Invary/cnc/README.md

# How to setup/use CNC3040 with GRBL

## About　

Smaller CNCs such as the CNC3018 use GRBL as the controller. <br />
However, for CNC3040 and above, Mache 3/4, which is older in design and less user-friendly, is often used. Here we show how to build a CNC3040 system with GRBL/wifi. <br />

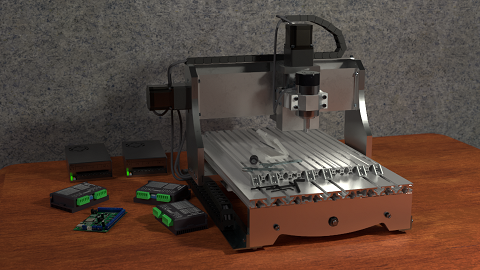
[picture p1: img/all_480x270.png]
CNC3040


<br />

## Preparation / CNC3040Z

Required <br/>
* CNC DIY frame. 3Axis [CNC3040Z](https://s.click.aliexpress.com/e/_DC8N8X1) without motor <br />
* 2 motor. Dual 8mm shaft NEMA23 motor, [23HS5628-SZ](https://s.click.aliexpress.com/e/_Dlx0W5N) for X/Z axis <br />
* 1 motor. Mono 8mm shaft NEMA23 motor, [23HS5628-8mm](https://s.click.aliexpress.com/e/_DmWwv0B) for Y axis <br />
* 3 coupling, [8mm x 8mm](https://s.click.aliexpress.com/e/_DkbfAH5) <br />
* 3 driver. [DM542](https://s.click.aliexpress.com/e/_DnLqMan) <br />
* Spindle. [BLDC 300W spindle](https://s.click.aliexpress.com/e/_DeVVoub) with driver, holder, speed meter and ER11 <br />
* GRBL board. [32bit 6axis CNC card](https://s.click.aliexpress.com/e/_DBUy0Rt) <br />
* Power unit. [24V 360W-Quiet](https://s.click.aliexpress.com/e/_DdIBWQr) for motors <br />
* Power unit. [36V 400W-Quiet](https://s.click.aliexpress.com/e/_DdIBWQr) for spindle <br />
* Shielded cable. [4core 18AWG 10m](https://s.click.aliexpress.com/e/_DBOf5Yn) for motors <br />
* Shielded cable. [3core 18AWG 5m](https://s.click.aliexpress.com/e/_DBOf5Yn) for spindle <br />
* microSD card. 1GB <br />

Optional <br />
* Ribon cable. [28AWG 5m](https://s.click.aliexpress.com/e/_DCX7pV1) <br />
* XH2.54 connector. [230Pcs XH2.54](https://s.click.aliexpress.com/e/_Dmz7UOf) for motors <br />
* Ferrule connector. [Many types of 340pcs](https://s.click.aliexpress.com/e/_DCKdpaT) for GRBL board and drivers <br />
* Terminal connector. [OT-3A](https://s.click.aliexpress.com/e/_DBOf5Yn) for power units <br />
* Drag chain. [inner size 10x20mm 2m](https://s.click.aliexpress.com/e/_DDre0dV) <br />
* Cable tie. [3x100mm](https://s.click.aliexpress.com/e/_DB07H2F) <br />
* 3D printer <br />

** Shielded cable is required. Unshielded cables will cause motor errors such as stalling. <br />

<br />

## Test wifi connection

GRBL board, [32bit 6axis CNC card](https://s.click.aliexpress.com/e/_DBUy0Rt), is equipped with an EPS32 and has a standard [FluidNC](https://github.com/bdring/FluidNC)(GRBL for ESP32) firmware burned in. <br />
Wireless connectivity is supported. Before wiring, first check this operation. <br />
This board is compatible with 12-24V power supply, 36V is not support. <br />

Connect to 24V power supply. Then the on-board LED glows momentarily and ESP32 operates as an access point mode. <br />
Enable the wireless on your smartphone or PC and you can find the SSID **`GRBL_ESP`**. The password is **`12345678`**. <br />

Once connected to the GRBL board, access **`http://192.168.100.101/`** in your browser. <br />
If connection failed, try another URL **`http://192.168.100.104/`** , **`http://192.168.101.100/`** or so on. Or, open a command prompt on your PC and run **`arp -a`** to identify the IP address = URL. <br />

<br />

## Motors wiring

GRBL board, [32bit 6axis CNC card](https://s.click.aliexpress.com/e/_DBUy0Rt), is equipped with an EPS32 and has a standard [FluidNC](https://github.com/bdring/FluidNC)(GRBL for ESP32) firmware burned in. <br />

* PUL/DIR/EN pins are 5V high/low output. DO NOT connect to over 5V voltage power supply. <br />
* High voltage of PWM-OUT is adjustable. <br />
* Both 24V pins are directly connected. Therefore, they can be used for both IN and OUT. <br />

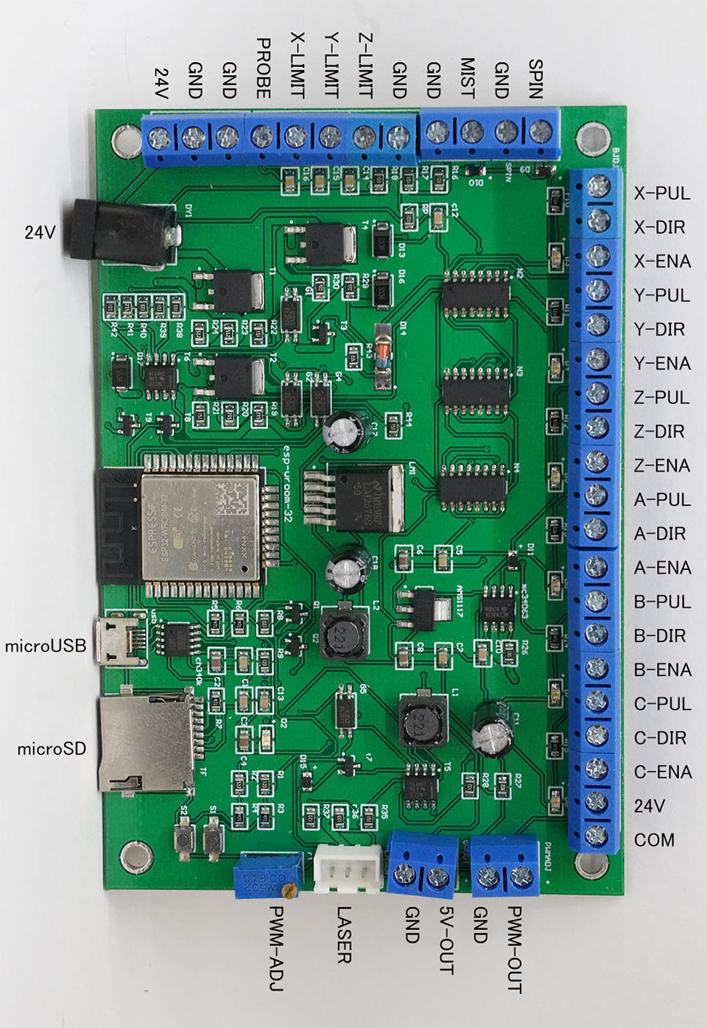
[picture p2: img/grbl_board_960x1396.png]
GRBL board


<br />

[DM542](https://s.click.aliexpress.com/e/_DnLqMan) is stepper motor driver. <br />
This is compatible with 20-50V power supply. <br />

* PUL-/DIR-/ENA- pins are connected to GND. <br />
* If you want to keep motor always on, connect both ENA+/ENA- pins to GND. <br />
* When wiring more than 2m, use shileded cable, or motor trouble will occur. <br />

<br />

Dual 8mm shaft NEMA23 motor, [23HS5628-SZ](https://s.click.aliexpress.com/e/_Dlx0W5N) for X/Z axis <br />
Mono 8mm shaft NEMA23 motor, [23HS5628-8mm](https://s.click.aliexpress.com/e/_DmWwv0B) for Y axis <br />
23HS5628 is 56mm height, 2.8A, 126N.cm. <br />

* Pin assignments vary by product, so check with a tester. <br />

<br />

The direction of motor rotation is not important because it can be changed by software.

DIP switch setting of DM542 is **`1.0A`**, **`Full Current`**, **`25600`** steps, **`on on on on off off off on`**. <br />
The motor's rated current is 2.8 A, but it is better to keep the value small unless it is necessary because it generates more heat. <br />

CNC3040Z's ball screw are SFU1605 with 5mm pitch. <br />
In other words, the 25600 steps in DM542 are 5mm, so **`5120 steps/mm`**. <br />

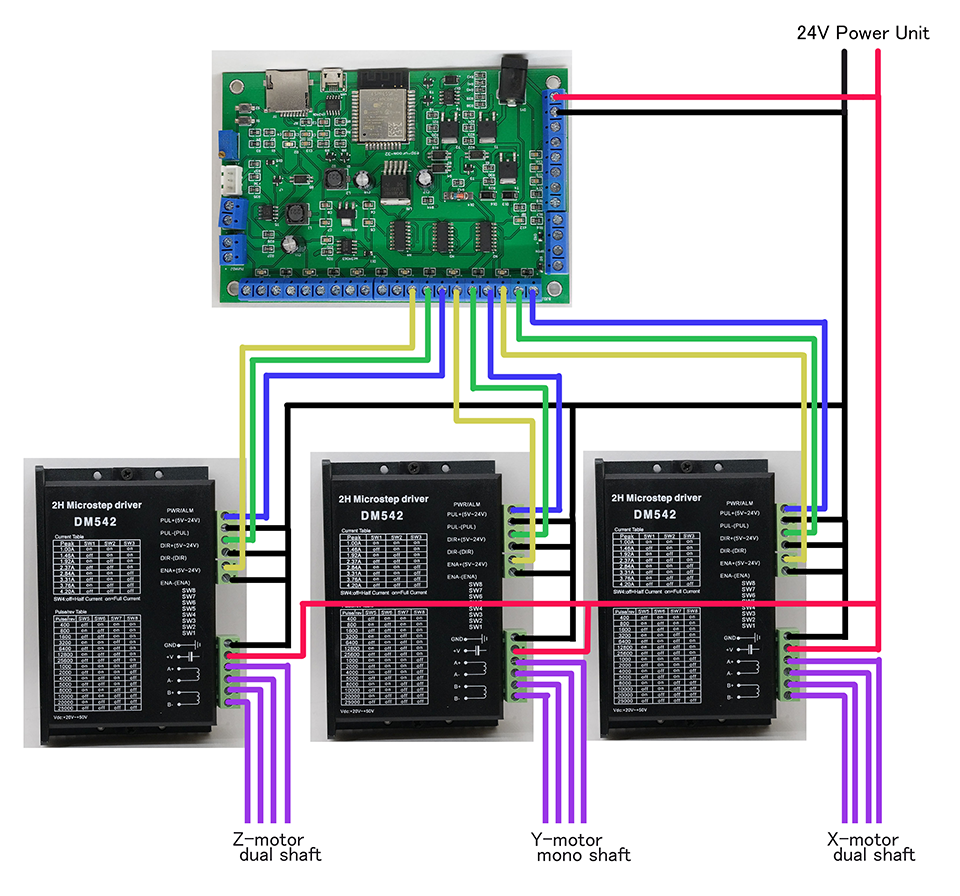
[picture p3: img/connection_motor_960x896.png]
Connections for motors


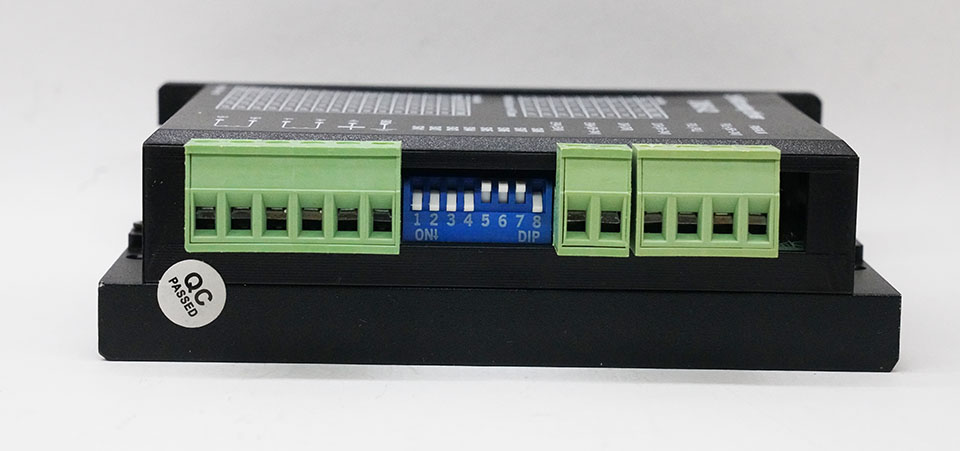
[picture p4: img/dm542_side_960x451.jpg]
Setting of DM542


<br />

## Spindle wiring

[WS55-180](https://s.click.aliexpress.com/e/_DeVVoub) is brushless spindle motor driver. <br />
RPM can be manually set by volume (10k ohm) or automatically adjusted by G-CODE. <br />

For automatic control, turn the **`PWM-ADJ`** volume to 0-10V PWM output before wiring. <br />
To adjust, access GRBL board with a browser. Set speed value **`1000`** in spindle tab and press the **`On Fwd`** button. Then voltage is output to PWM-OUT pin. Turn the **`PWM-ADJ`** volume so that the output is 10V. <br />

The direction of spindle rotation is important. Be sure to set correctly by change order U/V/W to U/W/V, etc., if in reverse. <br />
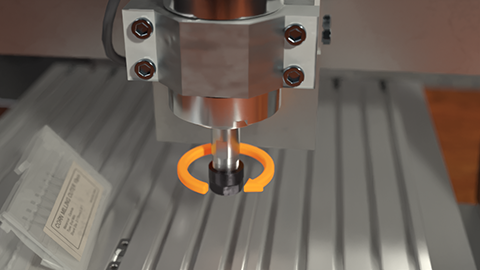
[picture p5: img/spindle_direction_480x270.png]
Auto control connections for spindle


- Manual control
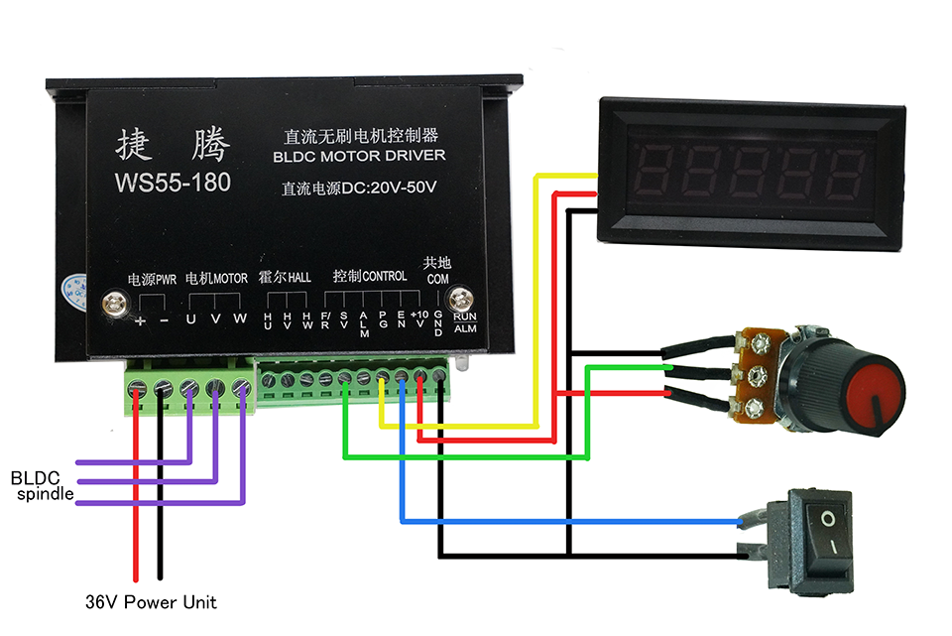
[picture p6: img/connection_spindle_manual_960x641.png]
Manual control connections for spindle


- Automatic control
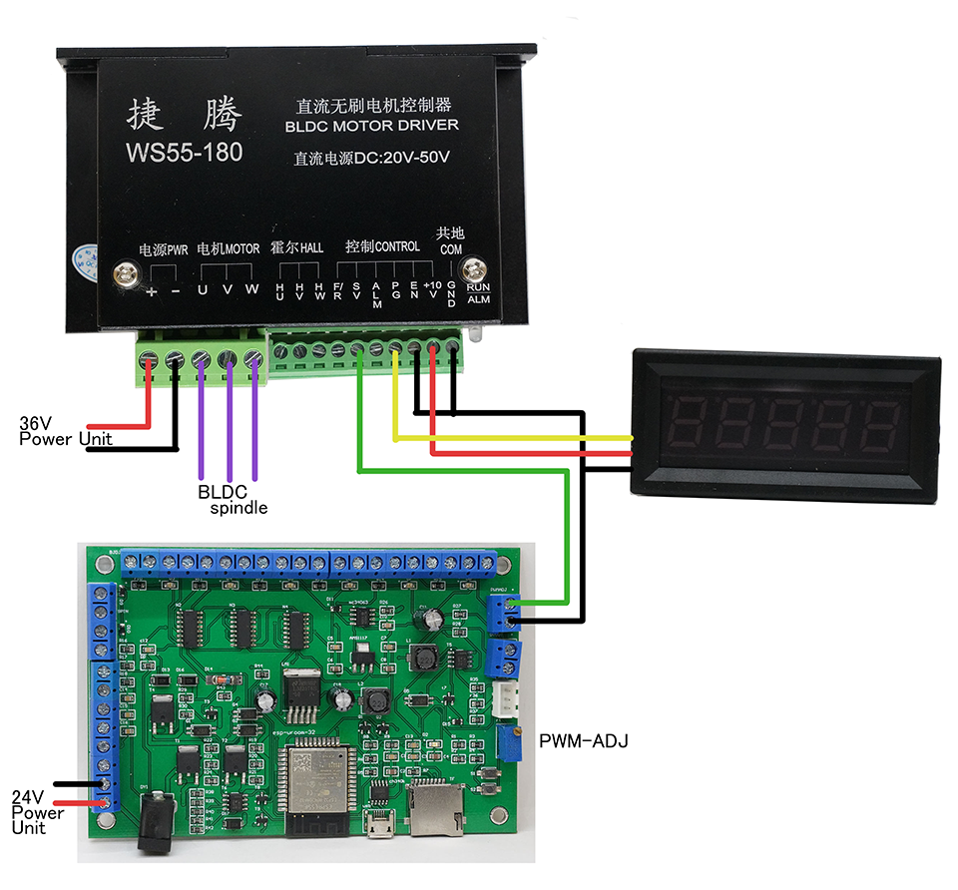
[picture p7: img/connection_spindle_auto_960x892.png]
Auto control connections for spindle


- Value in G-CODE vs RPM (no load)

| value |  rpm  |
| ----: | ----: |
| 200 |  2200 |
| 300 |  3800 |
| 400 |  5400 |
| 500 |  6800 |
| 600 |  8000 |
| 700 |  9200 |
| 800 | 10200 |
| 900 | 11300 |
|  1000 | 12000 |

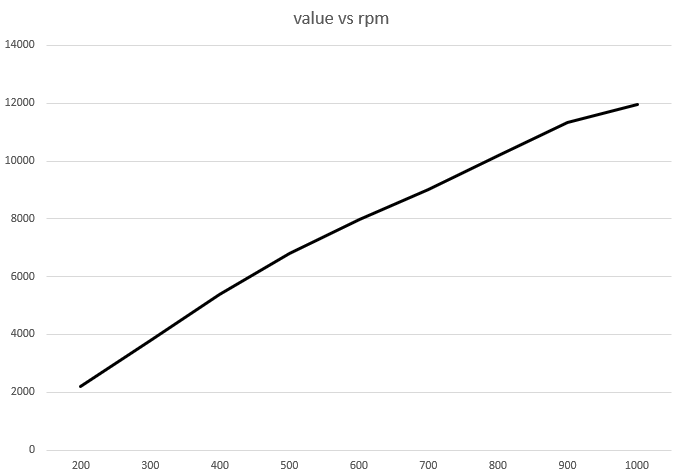
[picture p8: img/spindle_rpm_682x476.png]
g-code value vs rpm


<br />

## GRBL/[FluidNC](https://github.com/bdring/FluidNC) setting

To change the GRBL configuration, follow the steps below. <br />

1. Access GRBL board with browser <br />
2. Download the configuration file from GRBL board to your PC <br />
3. Edit the configuration file on your PC <br />
4. Upload the file to GRBL board <br />
5. Restart GRBL board <br />
<br />

Here is my [CNC3040Z configuration file](https://github.com/Invary/cnc/blob/main/cnc3040z.yaml) <br />

The various port settings on the GRBL board are not problm as default. <br />
The following items are important <br />

**`steps_per_mm:`** of X/Y/Z set to **`5120.000`**. <br />
**`max_rate_mm_per_min:`** of X/Y/Z set to **`500.000`**. <br />

**`homing:cycle:`** of X/Y set to **`1`**. <br />
**`homing:cycle:`** of Z/A/B/C set to **`0`**. <br />

**`max_travel_mm:`** of X set to **`300mm`**. <br />
**`max_travel_mm:`** of Y set to **`400mm`**. <br />
**`max_travel_mm:`** of Z set to **`100mm`**. <br />

**`start:must_home;`** set to **`false`**. <br />

When the direction of the stepping motor is reverse rotation, edit **`direction_pin:`**. <br />
Just add **`:low`** to reverse rotation, ex. **`direction_pin: I2SO.4`** to **`direction_pin: I2SO.4:low`** <br />

<br />

## Offline controller

GRBL board, [32bit 6axis CNC card](https://s.click.aliexpress.com/e/_DBUy0Rt), has no port for offline controller. <br />
But you can control via wifi. Although it is not an offline controller, it can be used like an offline controller. <br />

1. With smart phone, access GBRL board with browser. <br />
2. Open **`Tablet`** tab. <br />
3. You can control CNC via wifi. <br />

<br />

## Stand alone CNC machining

GRBL board, [32bit 6axis CNC card](https://s.click.aliexpress.com/e/_DBUy0Rt), has a microSD slot. <br />
Stand-alone processing is available by uploading g-code file in microSD. Upload can do via wifi. <br />

1. Access GBRL board with browser. <br />
2. Upload g-code file to microSD. File extension is like **`.nc`**. <br />
3. Set **`GRBL Reports:`** to **`Auto`** <br />
4. Set endmill to the spindle. <br />
5. Move spindle head to start position. <br />
6. Press **`⌀XYZABC`** button, work coordinates set to zero. <br />
7. Start CNC machining. <br />

If you want to abort, press pause and refresh button. <br />

<br />

## Serial connected CNC machining

GRBL board, [32bit 6axis CNC card](https://s.click.aliexpress.com/e/_DBUy0Rt), has a microUSB connector. <br />
It supports HID/serial protocol. So you can control CNC via serial port. <br />

<br />

## Serial connected CNC machining via wifi

GRBL board, [32bit 6axis CNC card](https://s.click.aliexpress.com/e/_DBUy0Rt) with firmware of [FluidNC](https://github.com/bdring/FluidNC), supports multiple wireless protocol. <br />
So you can control CNC via wifi, and by using a wireless-serial port bridge with virtual serial port, it can be controlled like as wired connected CNC. <br />

* Bluetooth/serial (not recommended) <br />
* WebSocket via wifi (not recommended) <br />
* Telnet via wifi (recommended) <br />

Bluetooth is for exclusive use with wifi. Therefore, enabling bluetooth is not recommended since wifi is not available. <br />

WebSocket is also used for control by browsers. This is not recommended as the connection is a bit unstable and can be dropped. <br />

So telnet/wifi is recommended. <br />

The following is an example of a setup is with [Candle](https://github.com/Denvi/Candle) for windows. <br />

1. Install virtual serial port [com0com](https://sourceforge.net/projects/com0com/files/com0com/3.0.0.0/). <br />
2. In setup of com0com, check **`enumulate baudrate`** and add one pair of virtual serial port, COM19 & COM20. <br />
3. [Download](https://github.com/Invary/IvyTcp2Serial/releases) latest version of [IvyTcp2Serial](https://github.com/Invary/IvyTcp2Serial/) and extract. <br />
4. Create shortcut file of **`IvyTcp2Serial.exe`** .<br />
5. Right click shortcut file and open property. <br />
6. Edit shortcut link **`IvyTcp2Serial.exe`** to **`IvyTcp2Serial.exe /server=192.168.100.101 /port=23 /comport=COM19 /baudrate=115200 /parity=none /stopbits=1`**. IP address and comport should be changed according to your environment. <br />
7. Execute IvyTcp2Serial with serial, and connected to CNC via wifi/telnet. <br />
8. Execute Candle with serial port like **`COM20`**. <br />
9. At first, send command to CNC, **`$Report/Interval=50`**. This is because the default frequency of coordinate report is low. <br />
10. Now you can control CNC via wifi with Candle. <br />

<br />

## Cable management

[CNC3040Z](https://s.click.aliexpress.com/e/_DC8N8X1) has several screw holes for cable management and comes with an adapter to secure the drag chain. <br />
However, we don't know which drag chain would fit perfectly. So, we made our own adapter with 3D printer. <br />

Usable drag chain is [inner size 10x20mm](https://s.click.aliexpress.com/e/_DDre0dV), close type. <br />
Since there are slight differences in size between drag chain products, it is better to design your own 3D printed parts without using stl. <br />

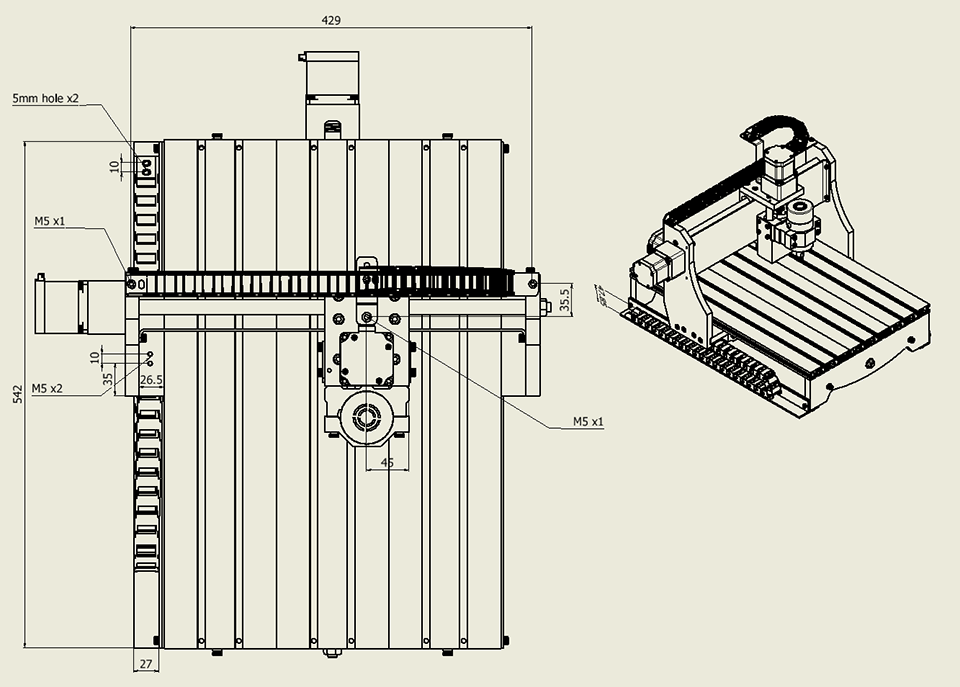
[picture p9: img/dimension_dragchain_hole_960x687.png]
Dimension for drag chain


The required length of the X axis drag chain is about 60cm. <br />

Stl file of [drag chain end cap for X axis type1](https://github.com/Invary/cnc/blob/main/model/3dprint/dragchain_end_x1.stl)
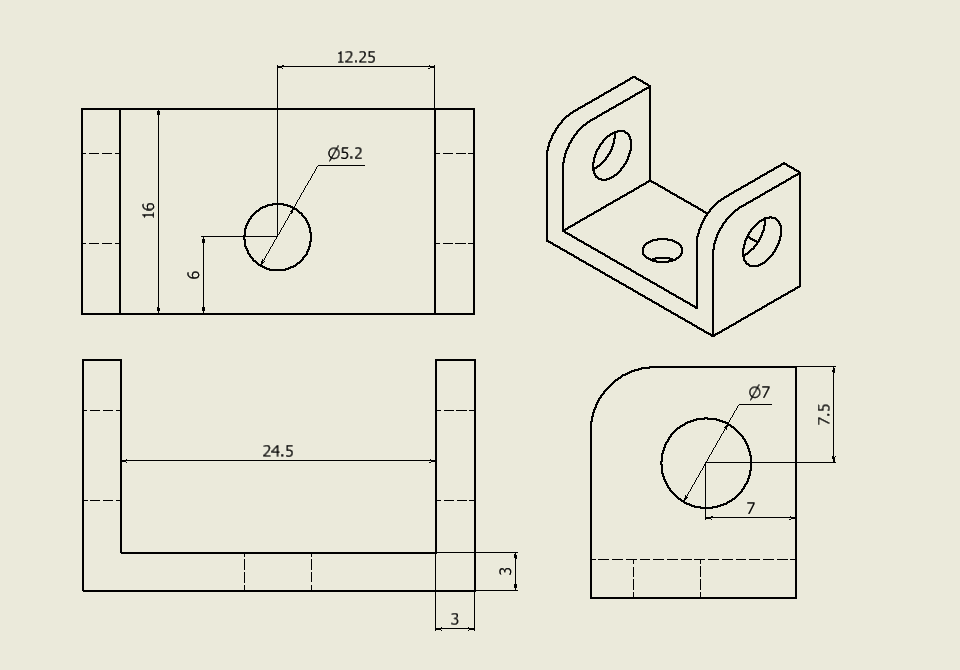
[picture p10: img/dragchain_end_x1_960x670.png]
drag chain end cap for X


Stl file of [drag chain end cap for X axis type2](https://github.com/Invary/cnc/blob/main/model/3dprint/dragchain_end_x2.stl) <br />
Multiple holes are for cable tie [3x100mm](https://s.click.aliexpress.com/e/_DB07H2F) <br />
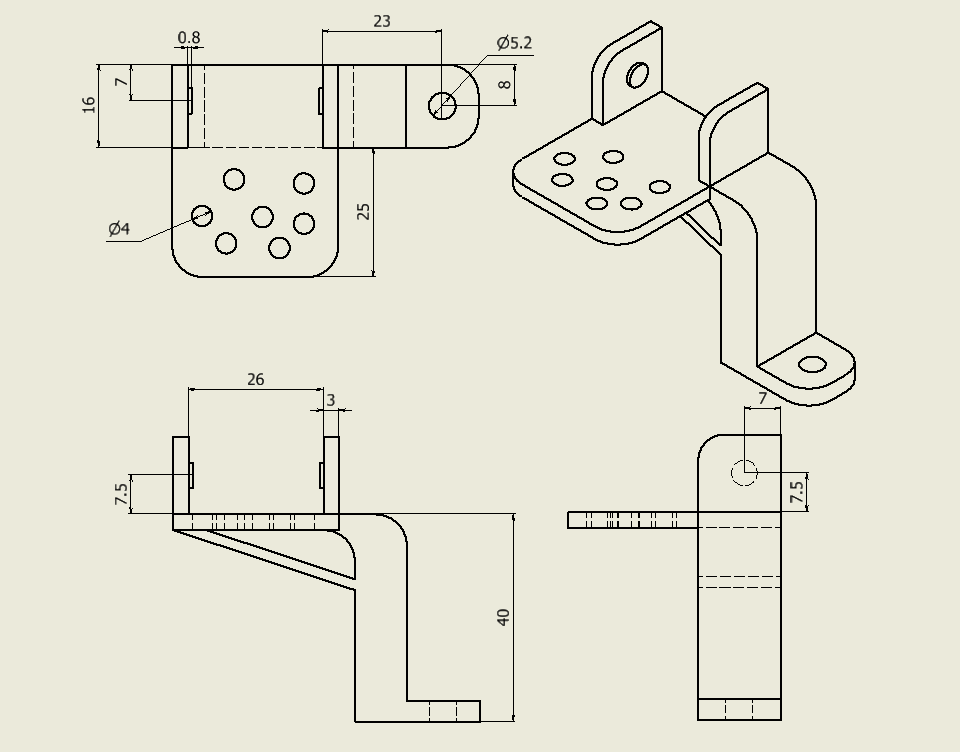
[picture p11: img/dragchain_end_x2_960x752.png]
drag chain end cap for X


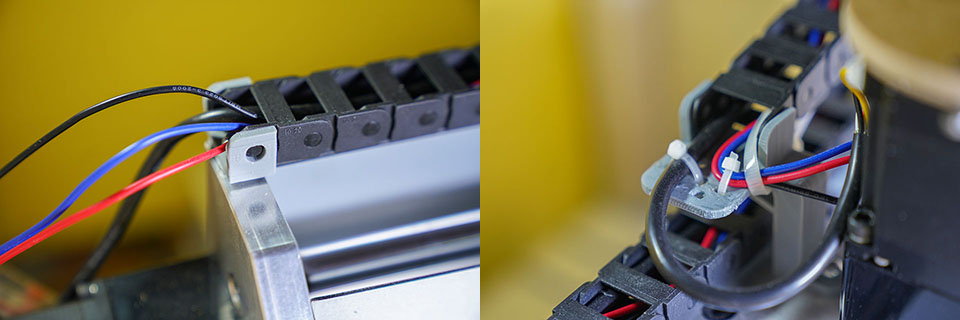
[picture p12: img/DSC06139_960x320.JPG]


The required length of the Y axis drag chain is about 70cm. <br />
The gap between the stage and the side panel is 26.5mm, which is a little narrow for a drag chain. Therefore, it is fixed in an irregular manner. <br />

Stl file of [drag chain end cap for Y axis](https://github.com/Invary/cnc/blob/main/model/3dprint/dragchain_end_y.stl)
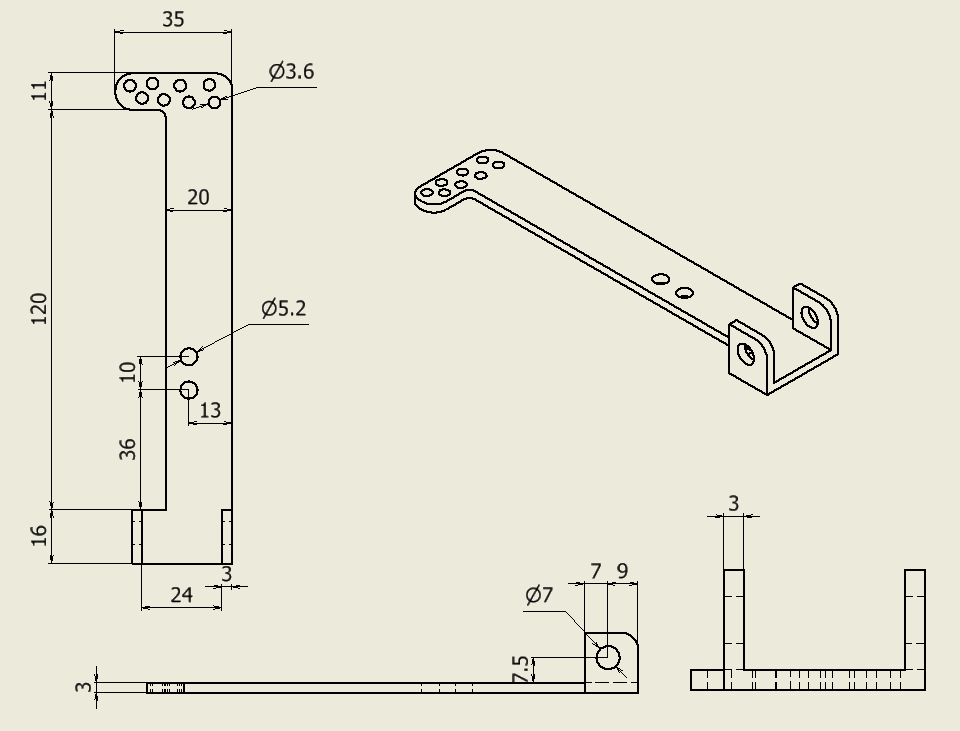
[picture p13: img/dragchain_end_y_960x731.png]
drag chain end cap for Y


M5 screw holes are provided near the Y-axis motor. This is used to secure the cable between Y-axis and X-axis. <br />
Stl file of [cable adapter between Y and X](https://github.com/Invary/cnc/blob/main/model/3dprint/cable_adapter.stl)
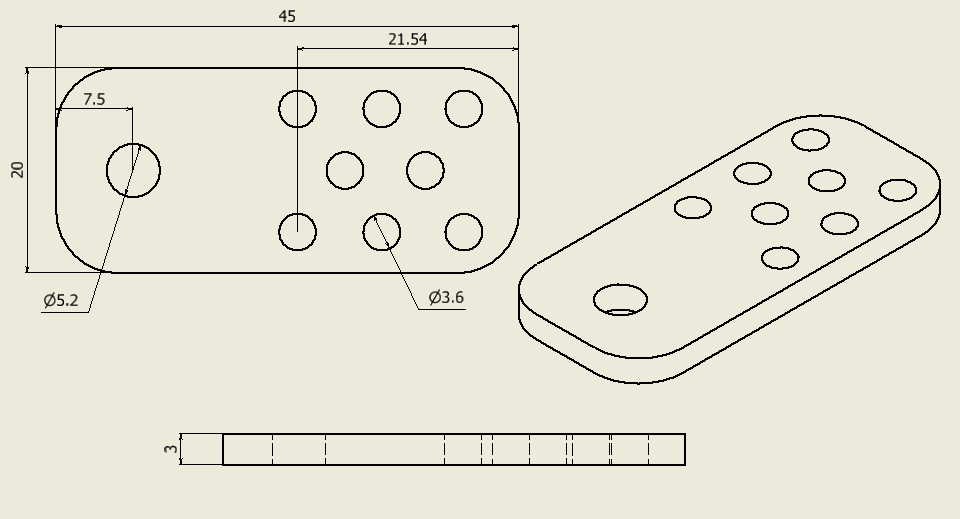
[picture p14: img/cable_adapter_960x519.png]
cable adapter between Y and X


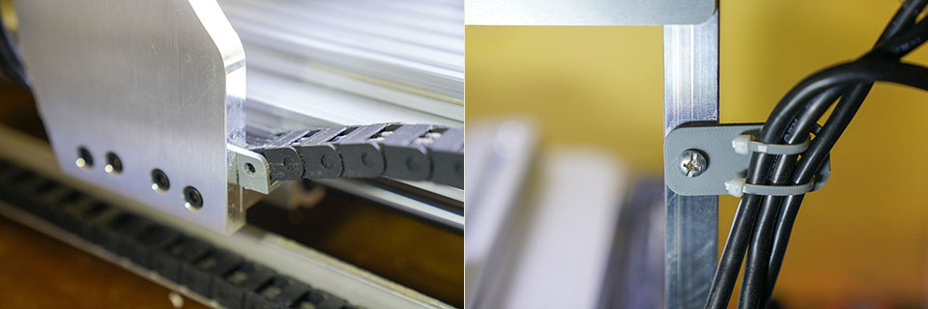
[picture p15: img/DSC06147_960x320.JPG]
drag chain end cap for Y, cable adapter between Y and X


<br />

## Power unit terminal guard

This CNC use 2 power units, [24V 360W-Quiet](https://s.click.aliexpress.com/e/_DdIBWQr) and [36V 400W-Quiet](https://s.click.aliexpress.com/e/_DdIBWQr). <br />
This power unit is easy to short-circuit because the terminals are exposed. Create a protective cover. <br />

Stl file of [Power unit terminal guard](https://github.com/Invary/cnc/blob/main/model/3dprint/power_unit_guard.stl)
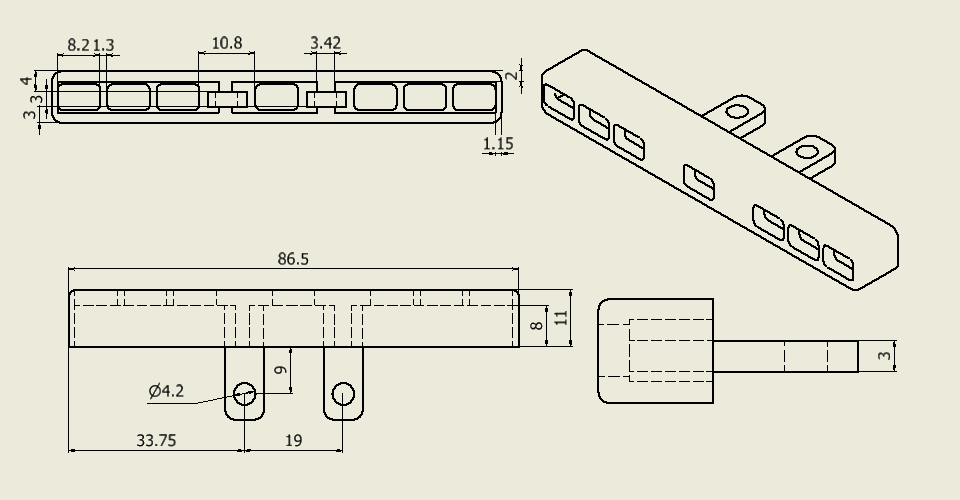
[picture p16: img/power_unit_guard_960x500.png]
Power unit guard


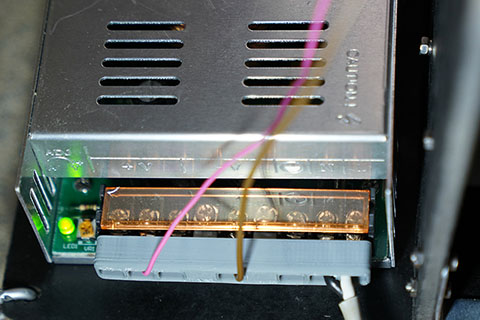
[picture p17: img/DSC06148_480x320.JPG]


<br />

## Knob for X/Z axis

Knob on dual shaft motor make manual position adjustment easier. <br />
So, for X/Z axis, It is better to use dual shaft motors, [23HS5628-SZ](https://s.click.aliexpress.com/e/_Dlx0W5N). <br />

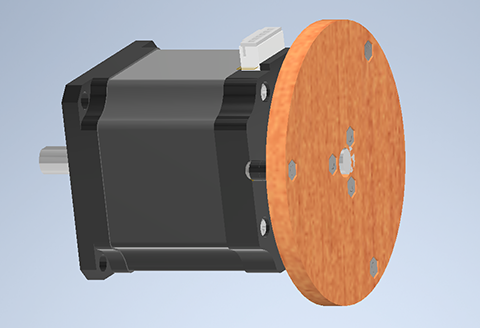
[picture p18: img/nema23_with_knob1_480x328.png]
NEMA23 with knob


Parts list
- x1 dual 8mm shaft NEMA23 motor, [23HS5628-SZ](https://s.click.aliexpress.com/e/_Dlx0W5N)
- x1 knob body, CNC machined 6mm thick MDF, [STL file](https://github.com/Invary/cnc/blob/main/model/3dprint/nema23_with_knob2.stl)
- x1 knob adapter, 3D printed, [STL file](https://github.com/Invary/cnc/blob/main/model/3dprint/nema23_with_knob4.stl)
- x6 spacer for small knob, CNC machined 3mm thick acrylic board, [STL file](https://github.com/Invary/cnc/blob/main/model/3dprint/nema23_with_knob5.stl)
- x4 M3-10mm screw
- x3 M3-12mm screw
- x7 M3 nut

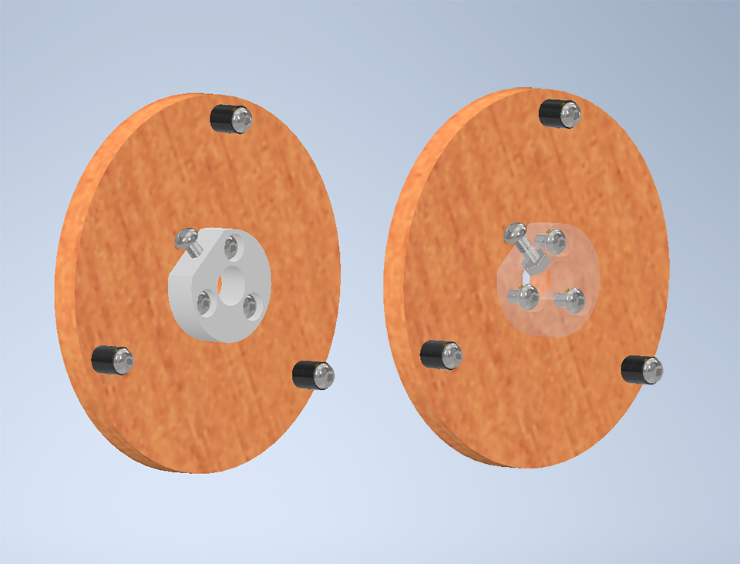
[picture p19: img/nema23_with_knob2_960x732.png]
knob


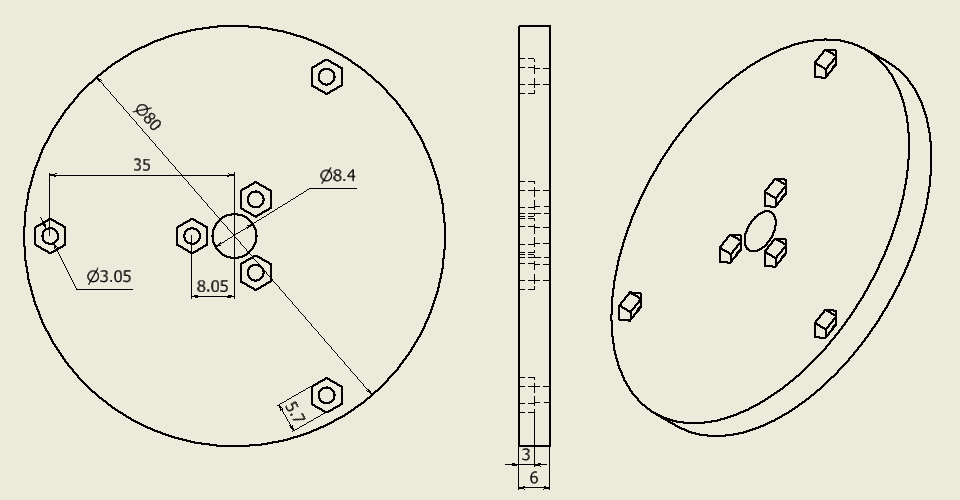
[picture p20: img/nema23_with_knob3_960x500.png]
knob body


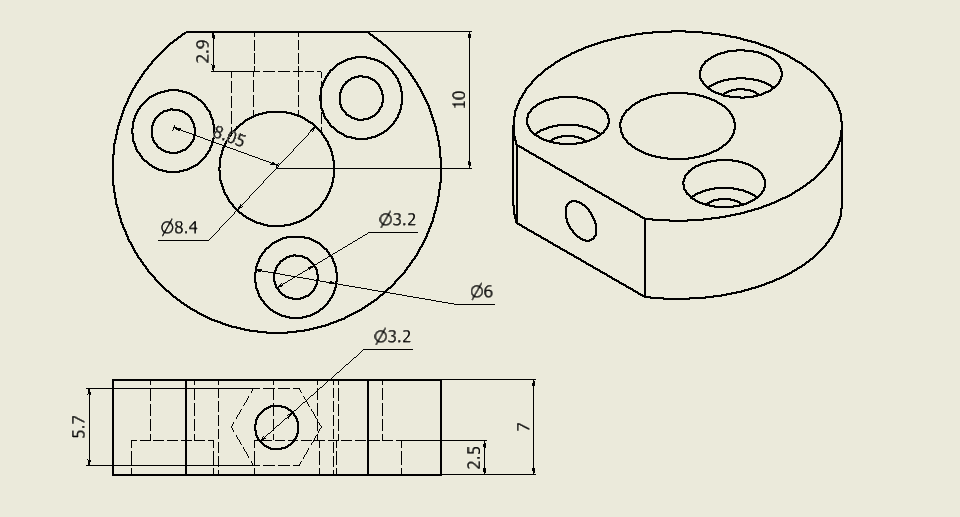
[picture p21: img/nema23_with_knob4_960x517.png]
knob adapter


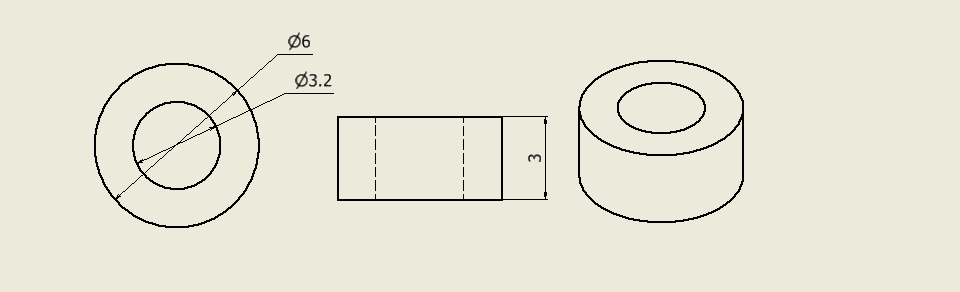
[picture p22: img/nema23_with_knob5_960x292.png]
knob spacer


<br />

## Knob for Y axis

The Y-axis of [CNC3040Z](https://s.click.aliexpress.com/e/_DC8N8X1) has ball bearing nut out. This nut is used to create the knob. <br />

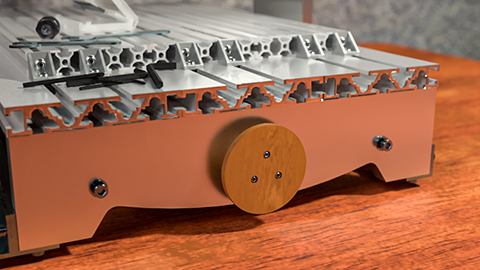
[picture p23: img/y_axis_knob_480x270.png]
Y-axis knob


Parts list
- x1 knob body, CNC machined 6mm thick MDF, [STL file](https://github.com/Invary/cnc/blob/main/model/3dprint/y_axis_knob_body.stl)
- x1 knob adapter, 3D printed, [STL file](https://github.com/Invary/cnc/blob/main/model/3dprint/y_axis_knob_adapter.stl)
- x3 M3-12mm screw
- x1 M3-10mm screw
- x4 M3 nut

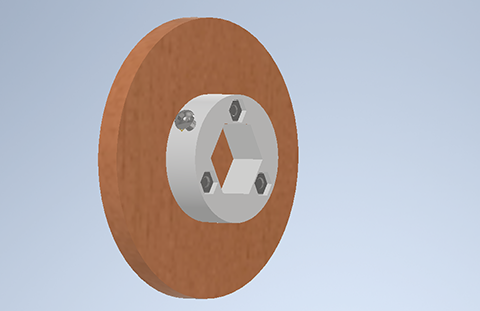
[picture p24: img/y_axis_knob2_480x311.png]
Y-axis knob

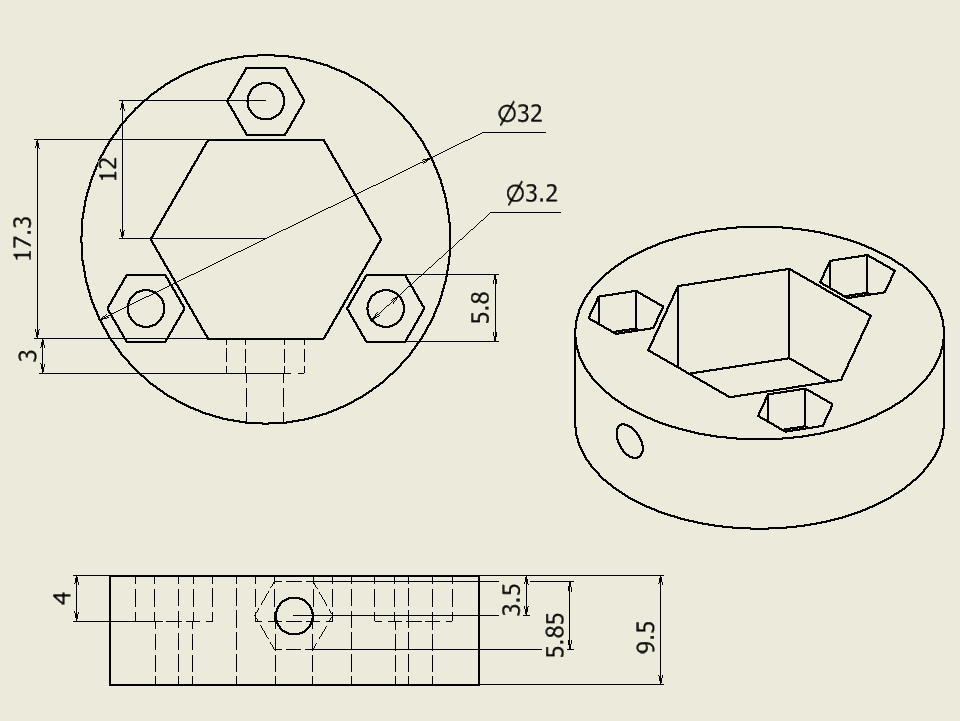
[picture p25: img/y_axis_knob_960x721.png]
Y-axis knob body

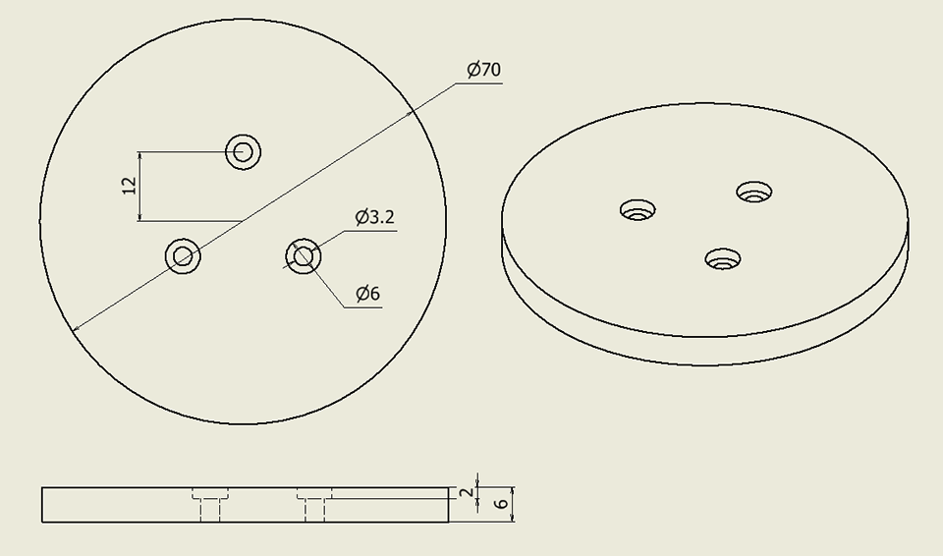
[picture p26: img/y_axis_knob_body_960x566.png]
Y-axis knob adapter


<br />

## 20 alminium profile stage

[CNC3040Z](https://s.click.aliexpress.com/e/_DC8N8X1) has 360x545mm stage using 3 pcs of [20120](https://s.click.aliexpress.com/e/_DnaMZth). <br />
This stage is common in CNC, but has some disadvantages such as wide groove spacing, necessity to use big screw for T-nut, etc. <br />
Therefore, change to user friendly 20 alminium profile stage. <br />

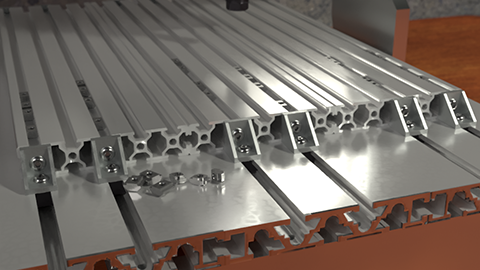
[picture p27: img/stage_480x280.png]
stage


Parts list
- x3 [20100 450mm](https://s.click.aliexpress.com/e/_DnaMZth)
- x12 [2020 corner bracket](https://s.click.aliexpress.com/e/_DkBTLRN)
- x12 [T-nut M6](https://s.click.aliexpress.com/e/_DB4cpVZ)
- x24 [M3, T slide nut 20](https://s.click.aliexpress.com/e/_DdnWJB5)
- x24 M6 screw

[20100 450mm](https://s.click.aliexpress.com/e/_DnaMZth) has has holes in the side. The diameter of this hole is 4.2mm or 5.0mm, depending on products. Use M5 or M6 tap to make threaded hole. <br />

<br />

## GRBL board's chips

GRBL board, [32bit 6axis CNC card](https://s.click.aliexpress.com/e/_DBUy0Rt) is not open source device. Threfore, schematic and specification are unknown.<br />
Looking at the PCB... there is some famous chips. We have not followed the schematic, but we predict the approximate function from PCB layout. <br />

- ESP32-WROOM-32: MPU module
- 74AHT595: 8bit shift register. X/Y/Z/A/B/C and maybe SPIN/MIST out is through this chip
- MC34063: DC-DC converter, 1.5A. Maybe for 5V-OUT
- AMS1117-3.3: 3.3V regulator. ESP32's power supply
- CH340K: USB-Serial bridge
- LM358 (up): opamp. Unknown
- LM358 (down): opamp. Maybe for PWM-OUT
- EL3H7: photo coupler. LIMIT/PROBE and maybe PWM for laser is isolated by this chip
- LM2576S: DC-DC converter, 3A. Maybe for laser power supply
- 20P06: P-ch power MOSFET. Unknown

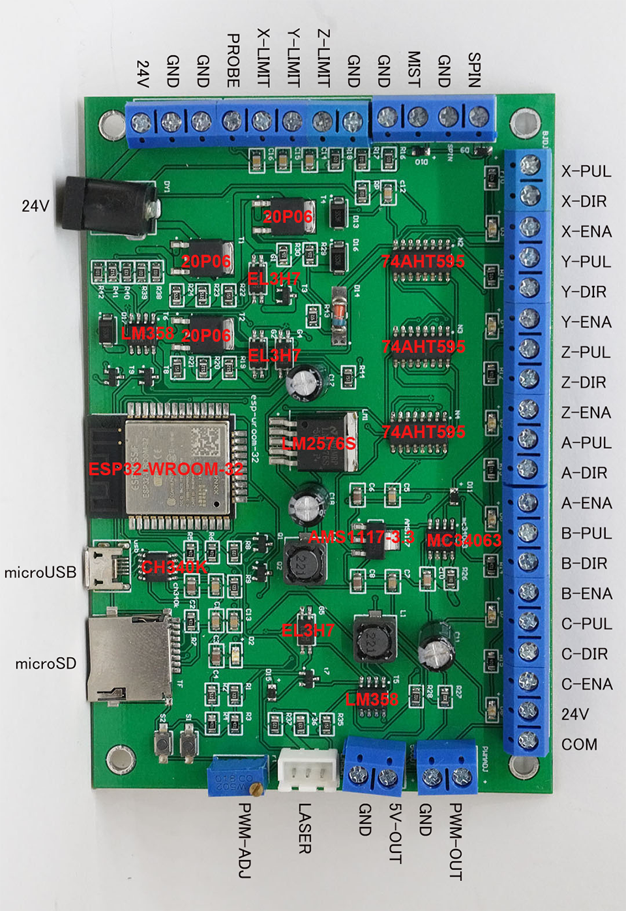
[picture p28: img/grbl_board_chip_960x1396.png]
GRBL board's chips


<br />

## Probe

Simple probe using a tactile switch. <br />

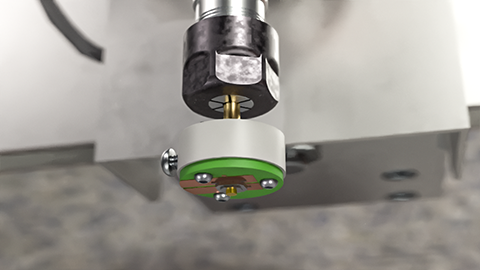
[picture p29: img/probe_480x270.png]
Probe

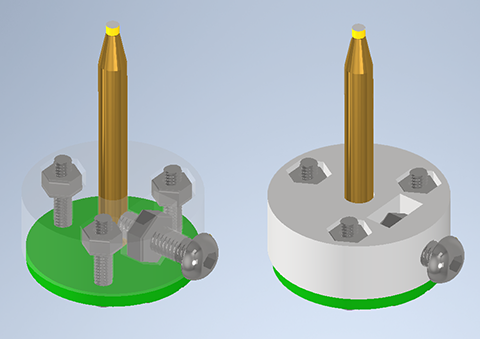
[picture p30: img/probe3_480x339.png]
Probe


Parts list
- x1 Probe base, 3D printed, [STL file](https://github.com/Invary/cnc/blob/main/model/3dprint/probe.stl)
- x1 [Bakelite single side PCB](https://s.click.aliexpress.com/e/_Dkmlcjh), [DXF file](https://github.com/Invary/cnc/blob/main/model/3dprint/probe.dxf)
- x1 Tactile switch [2.0mm height](https://s.click.aliexpress.com/e/_DmjSeC7)
- x1 3.175mm broken endmill
- x1 M3-10mm screw
- x3 M2-10mm screw
- x1 M3 nut
- x3 M2 nut

Generally, PCB pattern cutting is done by generating gcode from gerber and cutting with V-cutter. However, for a simple board like this, it is easier to use general CAD and endmill. <br />
In this case, we used [0.5mm corn endmill](https://s.click.aliexpress.com/e/_DmQo5hh). <br />

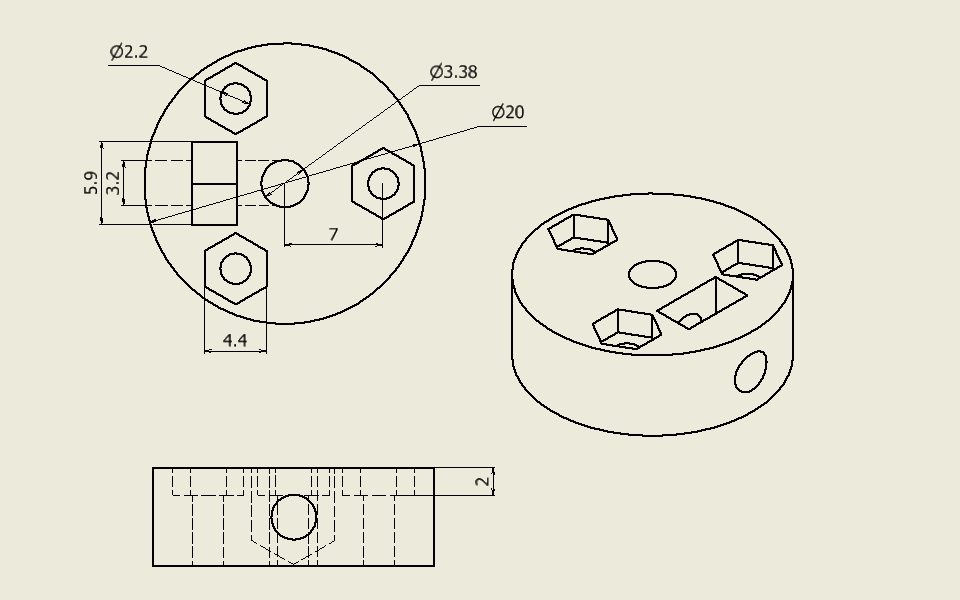
[picture p31: img/probe1_960x600.png]
Probe body

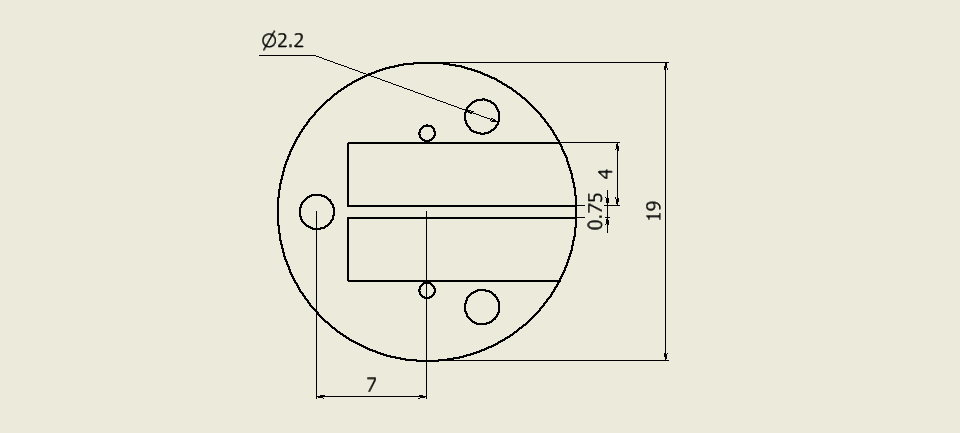
[picture p32: img/probe2_960x433.png]
Probe PCB pattern


<br />
<br />
<br />
<br />
<br />

##  Suggestions and feedback
If you have any idea or suggestion, please add a github issue.

<br />

<br />
<br />
<br />

#### Copyright (c) Invary
