Invary/cnc/img/dm542_1920x1080.jpg

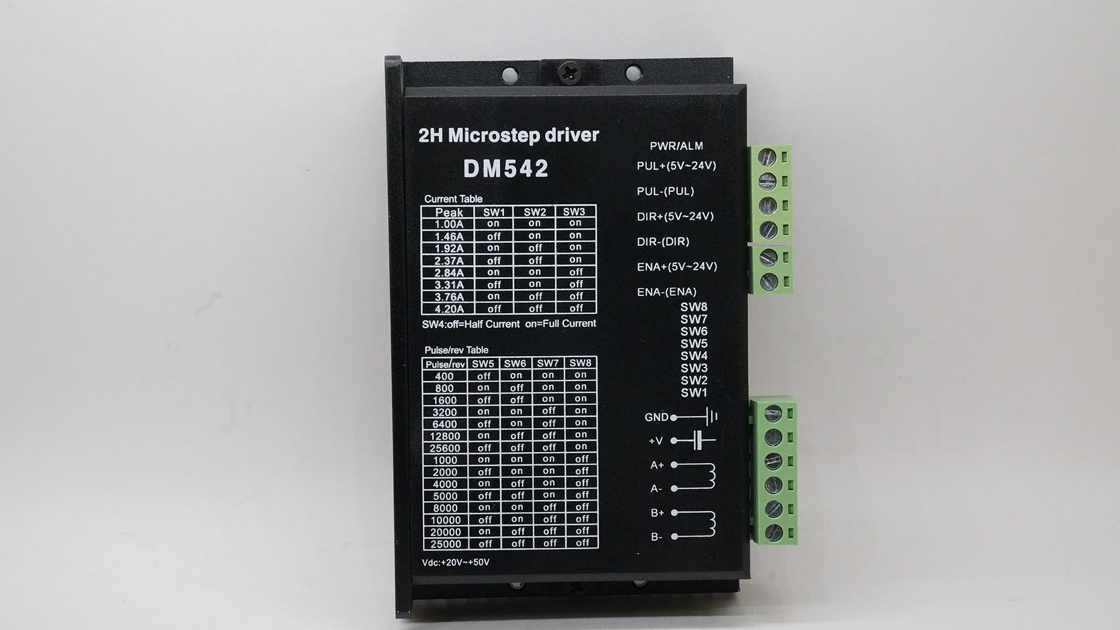
img/dm542_1920x1080.jpg
