Invary/cnc/img/DSC06122.JPG

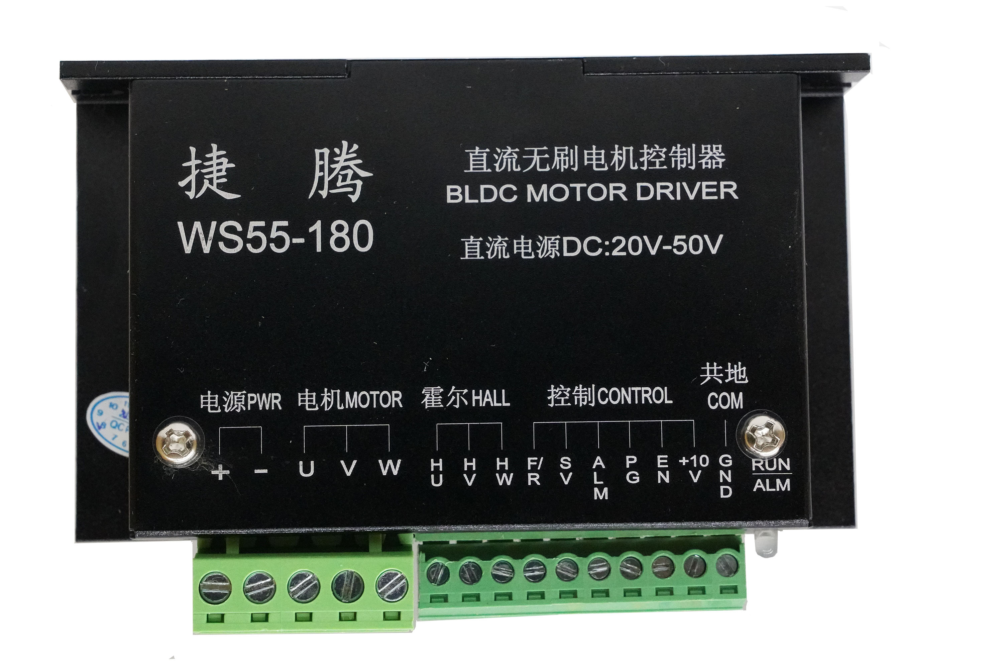
img/DSC06122.JPG
