Invary/cnc/img/grbl_board_1920x1080.jpg

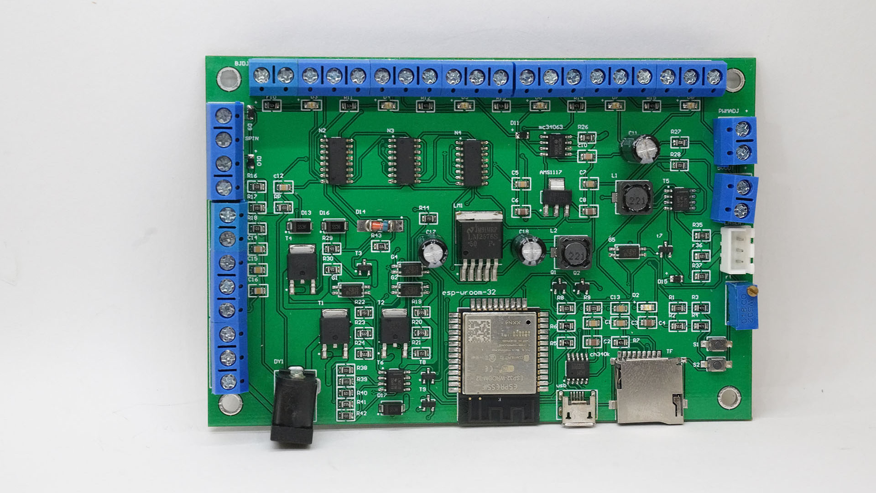
img/grbl_board_1920x1080.jpg
