Invary/cnc/model/3dprint/y_axis_knob_body.stl

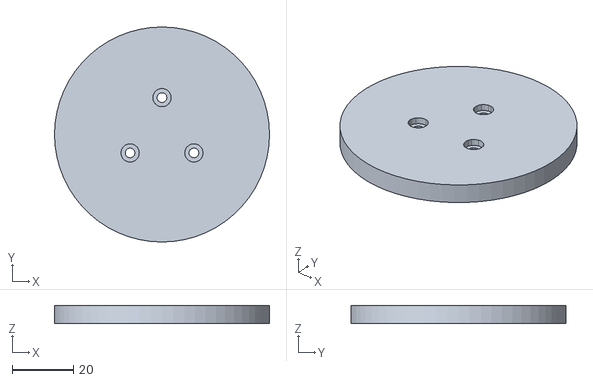
[picture p36: CAD file, 2023-11-14]
model/3dprint/y_axis_knob_body.stl
70.0 x 70.0 x 6.00
