Invary/cnc/model/3dprint/y_axis_knob_adapter.stl

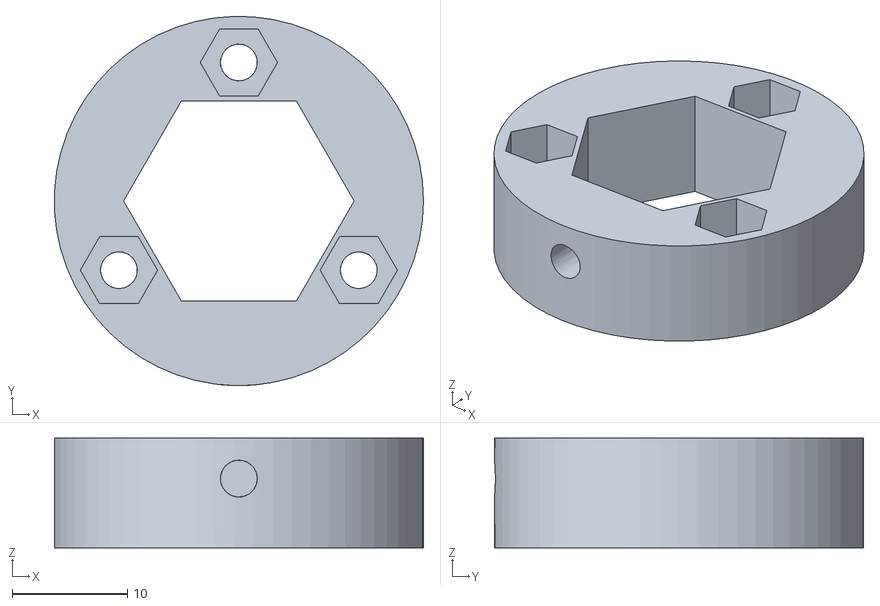
[picture p37: CAD file, 2023-11-14]
model/3dprint/y_axis_knob_adapter.stl
32.0 x 32.0 x 9.50
