Invary/cnc/model/3dprint/probe.stl

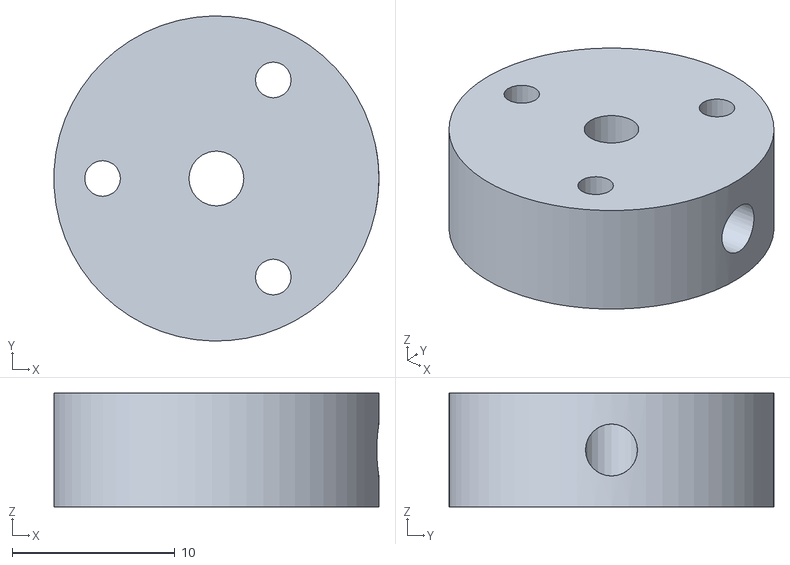
[picture p38: CAD file, 2023-11-14]
model/3dprint/probe.stl
20.0 x 20.0 x 7.00
