Invary/cnc/model/3dprint/nema23_with_knob2.stl

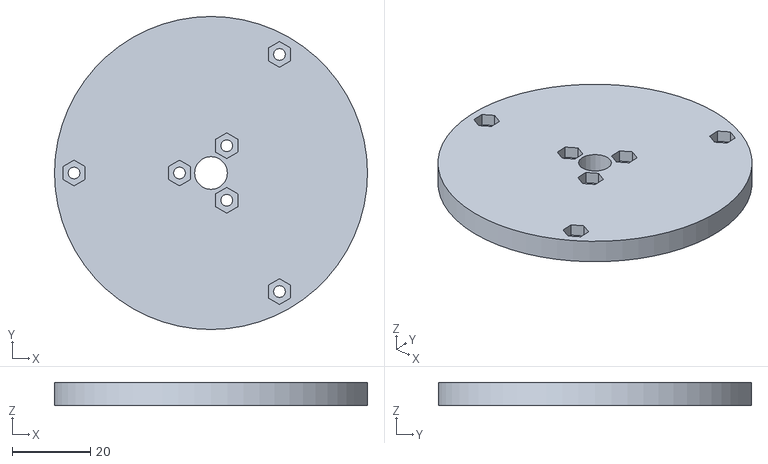
[picture p39: CAD file, 2023-11-12]
model/3dprint/nema23_with_knob2.stl
80.0 x 80.0 x 6.00
