Invary/cnc/model/3dprint/nema23_with_knob4.stl

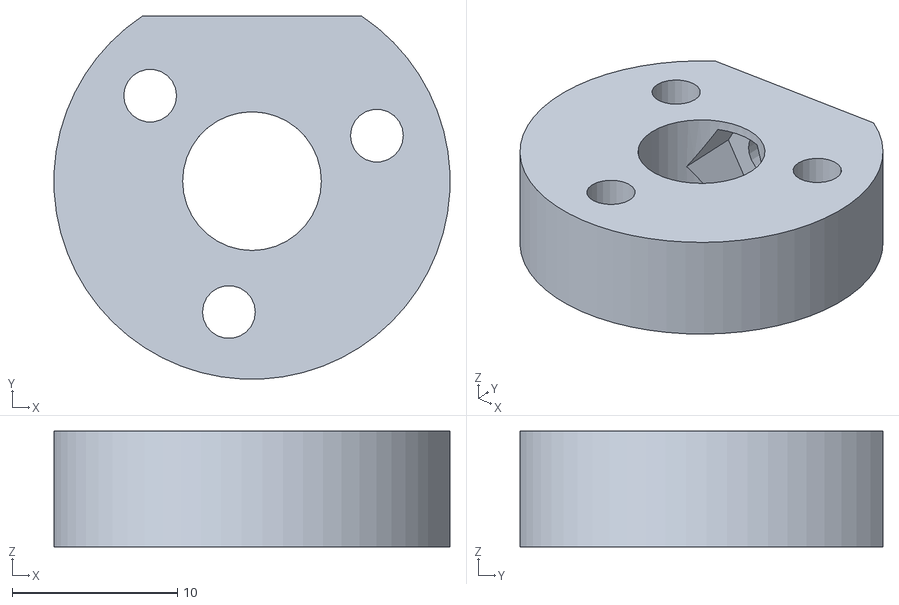
[picture p40: CAD file, 2023-11-12]
model/3dprint/nema23_with_knob4.stl
24.0 x 22.0 x 7.00
