Invary/cnc/model/3dprint/nema23_with_knob5.stl

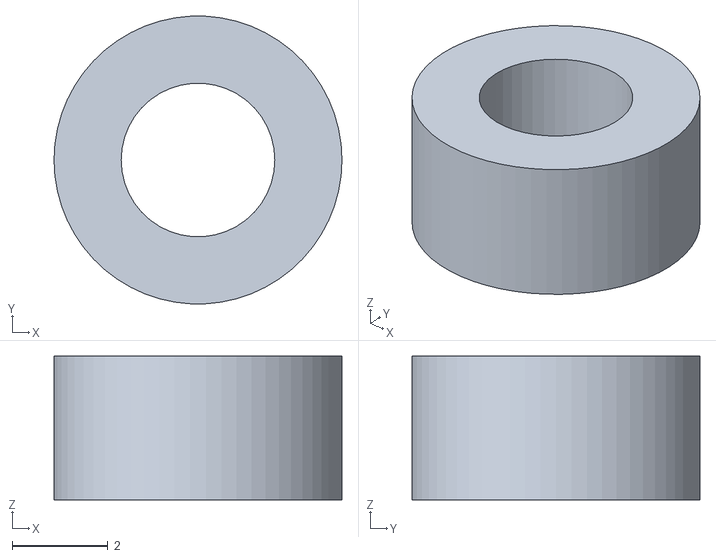
[picture p41: CAD file, 2023-11-12]
model/3dprint/nema23_with_knob5.stl
6.00 x 5.99 x 3.00
