Invary/cnc/model/3dprint/power_unit_guard.stl

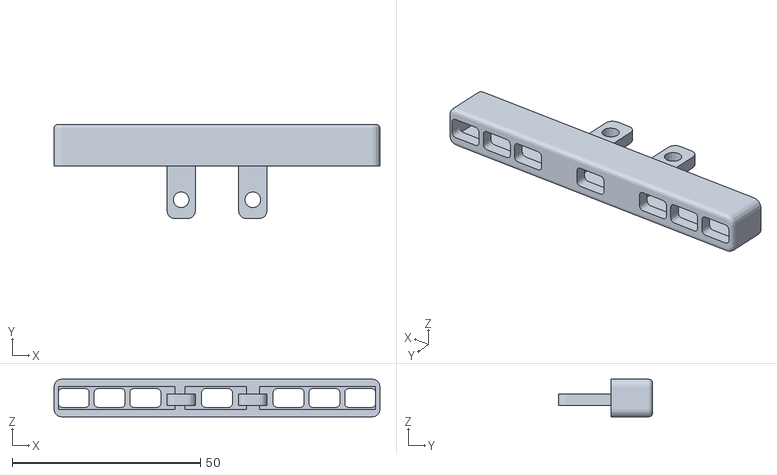
[picture p42: CAD file, 2023-11-11]
model/3dprint/power_unit_guard.stl
86.5 x 25.0 x 10.0
