Invary/cnc/model/3dprint/dragchain_end_x1.stl

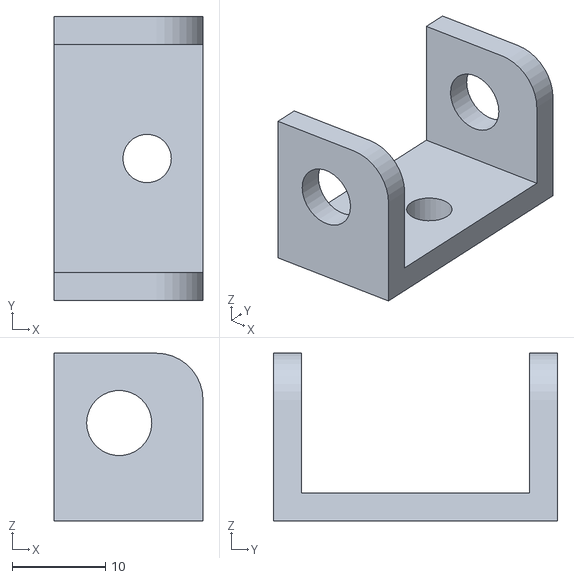
[picture p43: CAD file, 2023-11-11]
model/3dprint/dragchain_end_x1.stl
16.0 x 30.5 x 18.0
