Invary/cnc/model/3dprint/dragchain_end_x2.stl

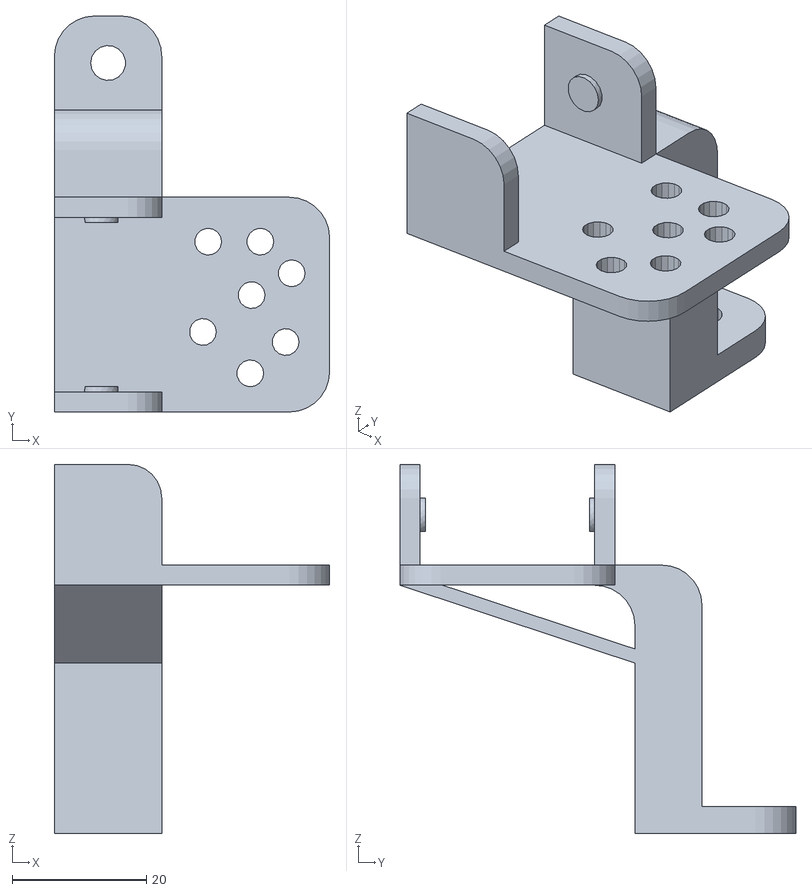
[picture p44: CAD file, 2023-11-11]
model/3dprint/dragchain_end_x2.stl
41.0 x 59.0 x 55.0
