Invary/cnc/model/3dprint/cable_adapter.stl

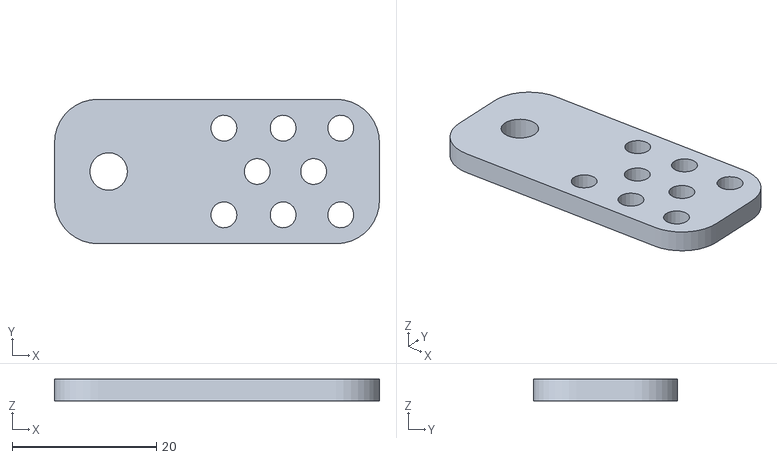
[picture p45: CAD file, 2023-11-11]
model/3dprint/cable_adapter.stl
45.0 x 20.0 x 3.00
