Invary/cnc/model/3dprint/dragchain_end_y.stl

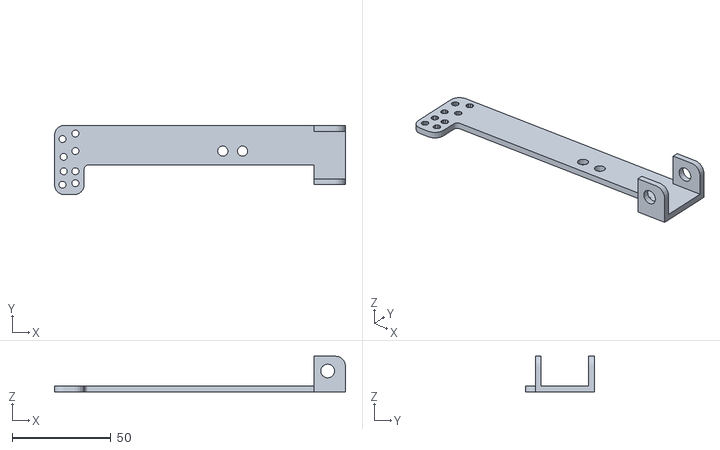
[picture p46: CAD file, 2023-11-11]
model/3dprint/dragchain_end_y.stl
147.0 x 35.0 x 18.0
