Invary/cnc/(list of files, cad)

Other CAD files:
model/3dprint/probe.dxf
