Invary/cnc/(commit log)

2023-11-11 add Cable management
    [cable_adapter.stl, dragchain_end_x1.stl, dragchain_end_x2.stl, dragchain_end_y.stl]
2023-11-11 fix Cable management
2023-11-11 add Power unit guard
    [power_unit_guard.stl]
2023-11-12 add spindle direction
2023-11-12 add Manual dial
    [nema23_with_dial2.stl, nema23_with_dial4.stl, nema23_with_dial5.stl]
2023-11-12 add stage
2023-11-13 add spindle rpm graph
2023-11-14 add Probe
    [probe.dxf, probe.stl]
2023-11-14 add Knob for Y axis
    [y_axis_knob_adapter.stl, y_axis_knob_body.stl]
